kaushik565/HEMA/20D0478_20201208_1146.pdf

# REED Switches I/F

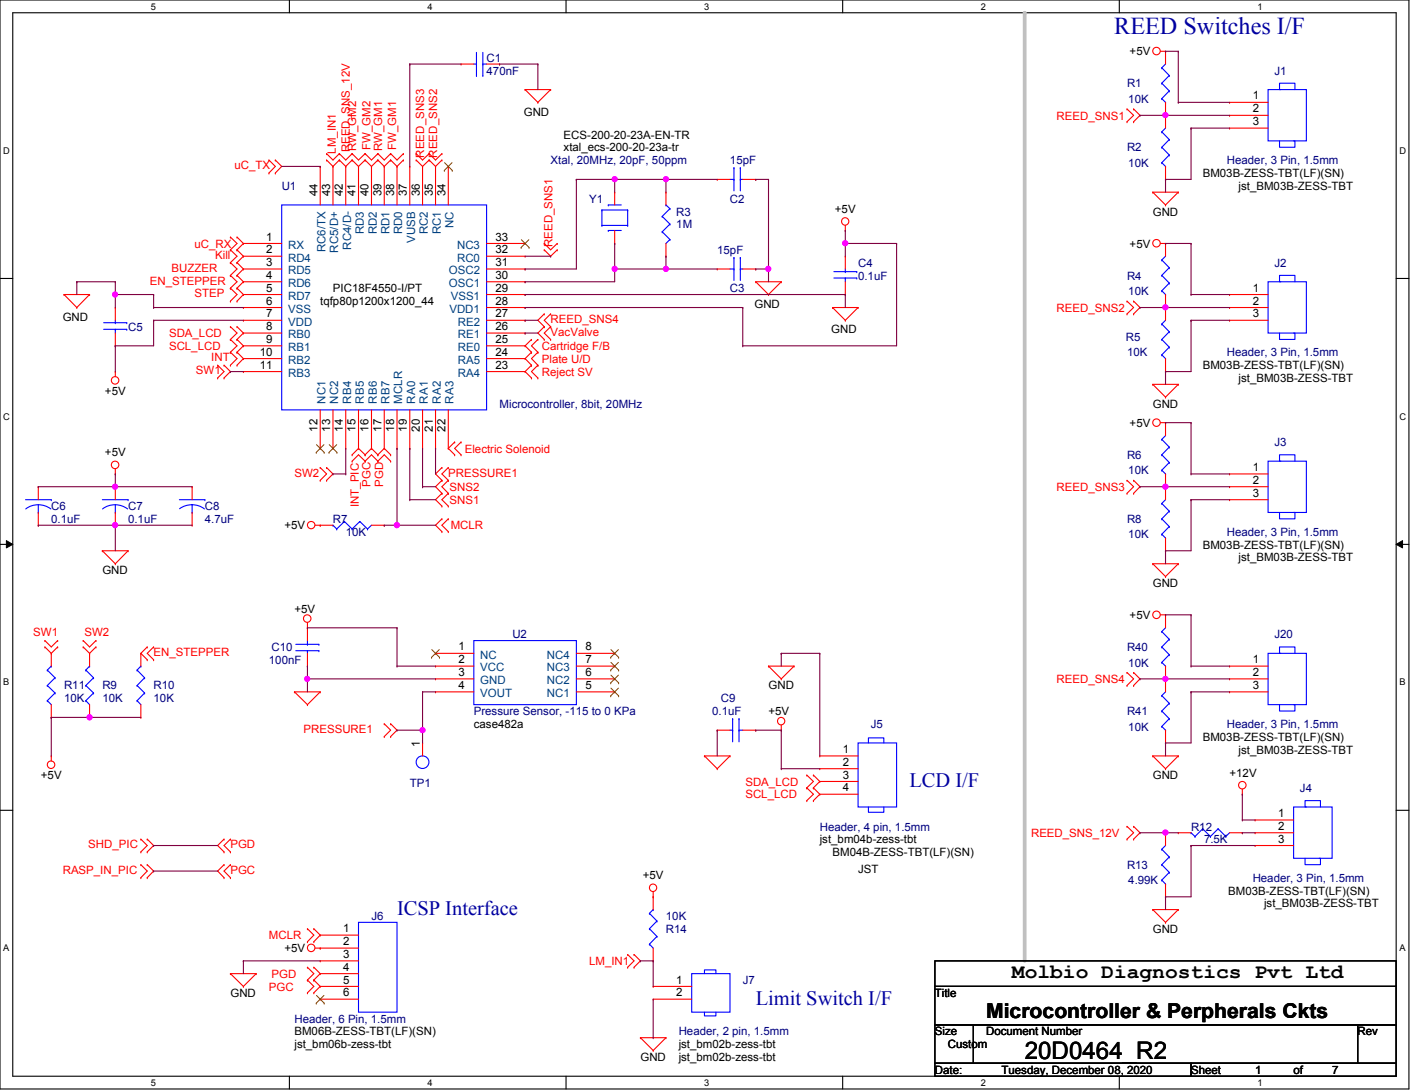
[picture p1: page 1]

Header, 3 Pin, 1.5mm
BM03B-ZESS-TBT(LF)(SN)

Pressure Sensor, -115 to 0 KPa
case482a

Header, 4 pin, 1.5mm
jst_bm04b-zess-tbt
BM04B-ZESS-TBT(LF)(SN)
JST

Molbio Diagnostics Pvt Ltd

Header, 6 Pin, 1.5mm
BM06B-ZESS-TBT(LF)(SN)
jst_bm06b-zess-tbt

## Valve Motor 1 Socket

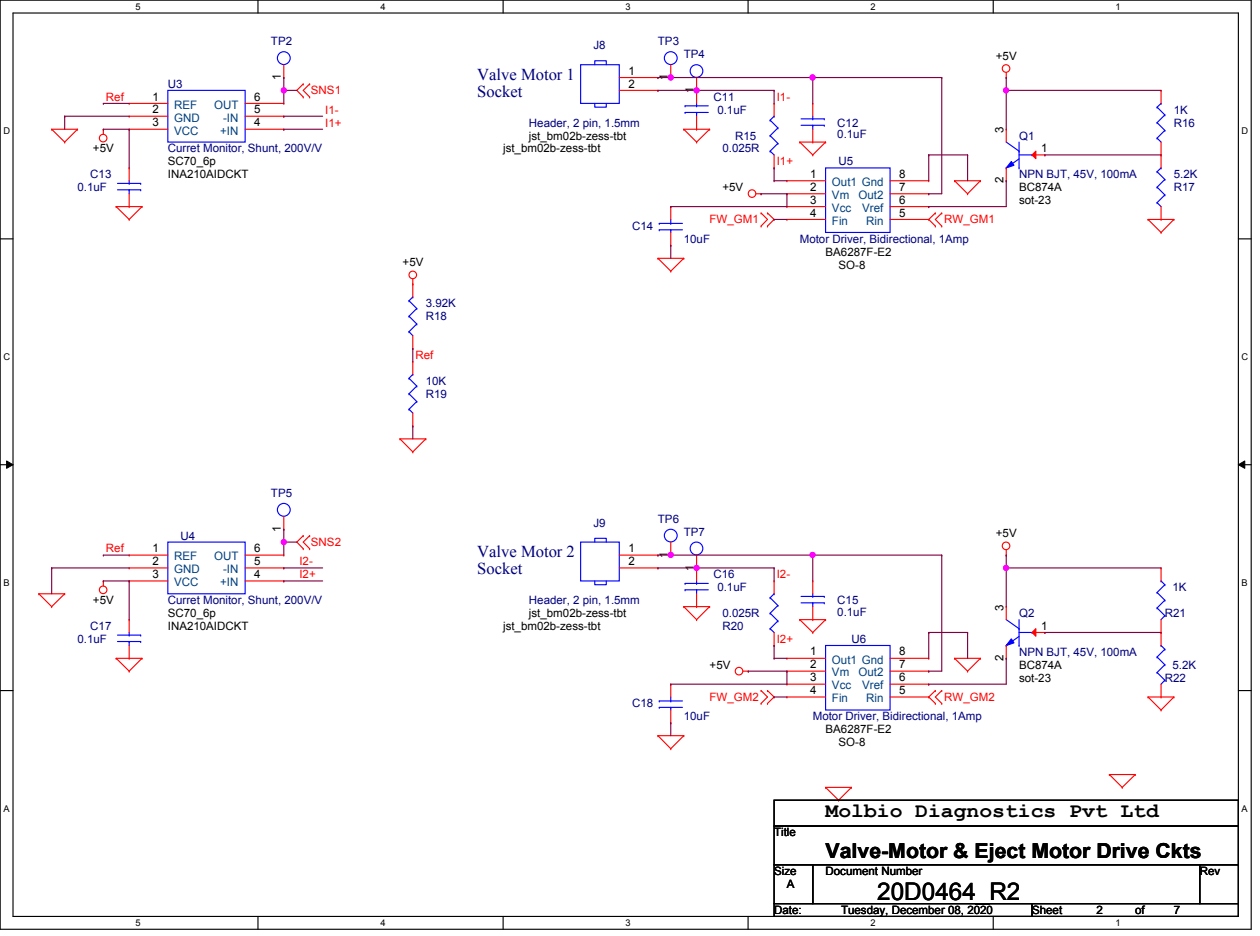
[picture p2: page 2]

Molbio Diagnostics Pvt Ltd

Title
Valve-Motor & Eject Motor Drive Ckts

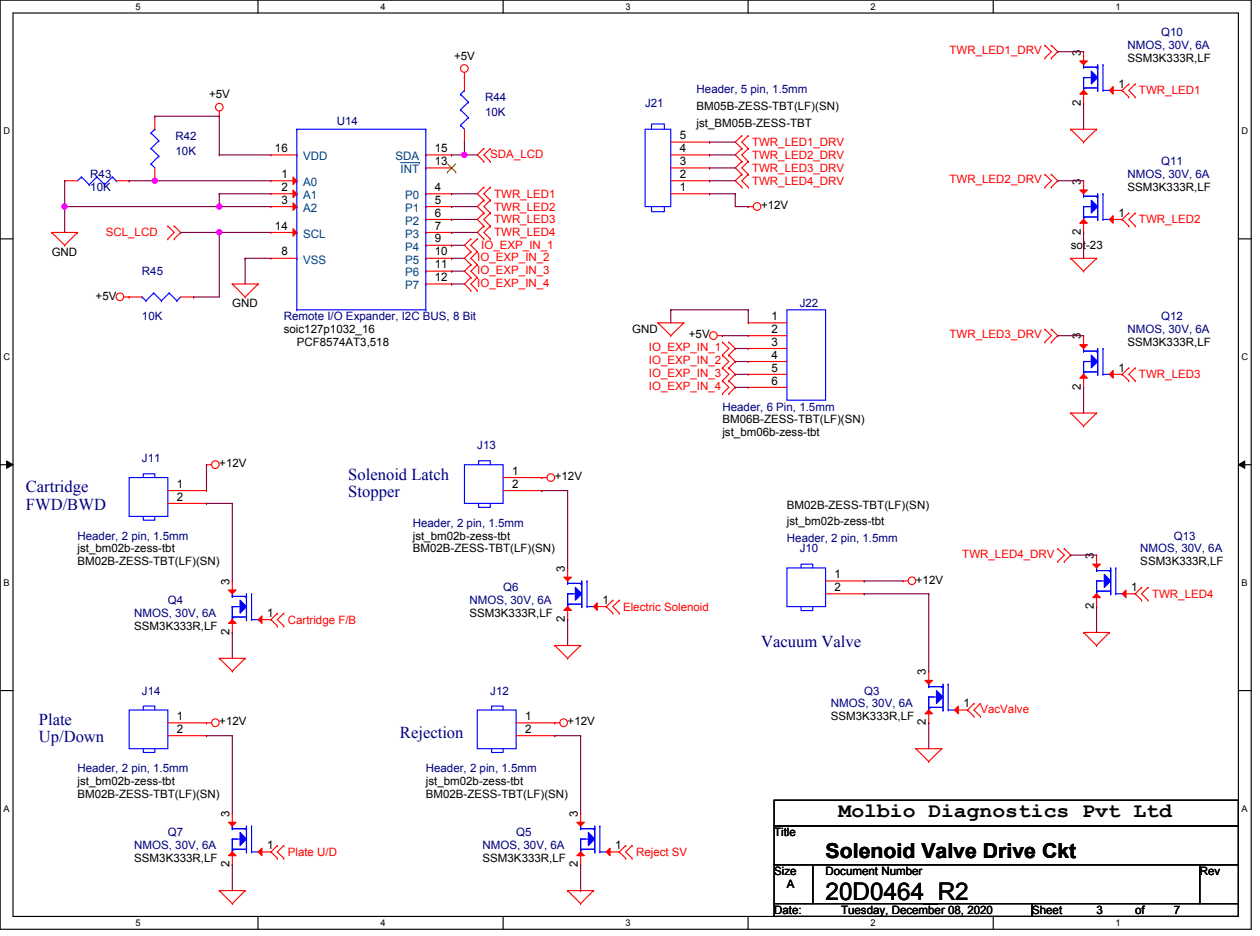
[picture p3: page 3]

Header, 6 Pin, 1.5mm
BM06B-ZESS-TBT(LF)(SN)
jst_bm06b-zess-tbt

BM02B-ZESS-TBT(LF)(SN)
jst_bm02b-zess-tbt
J10 Header, 2 pin, 1.5mm

Header, 2 pin, 1.5mm

Title
Solenoid Valve Drive Ckt

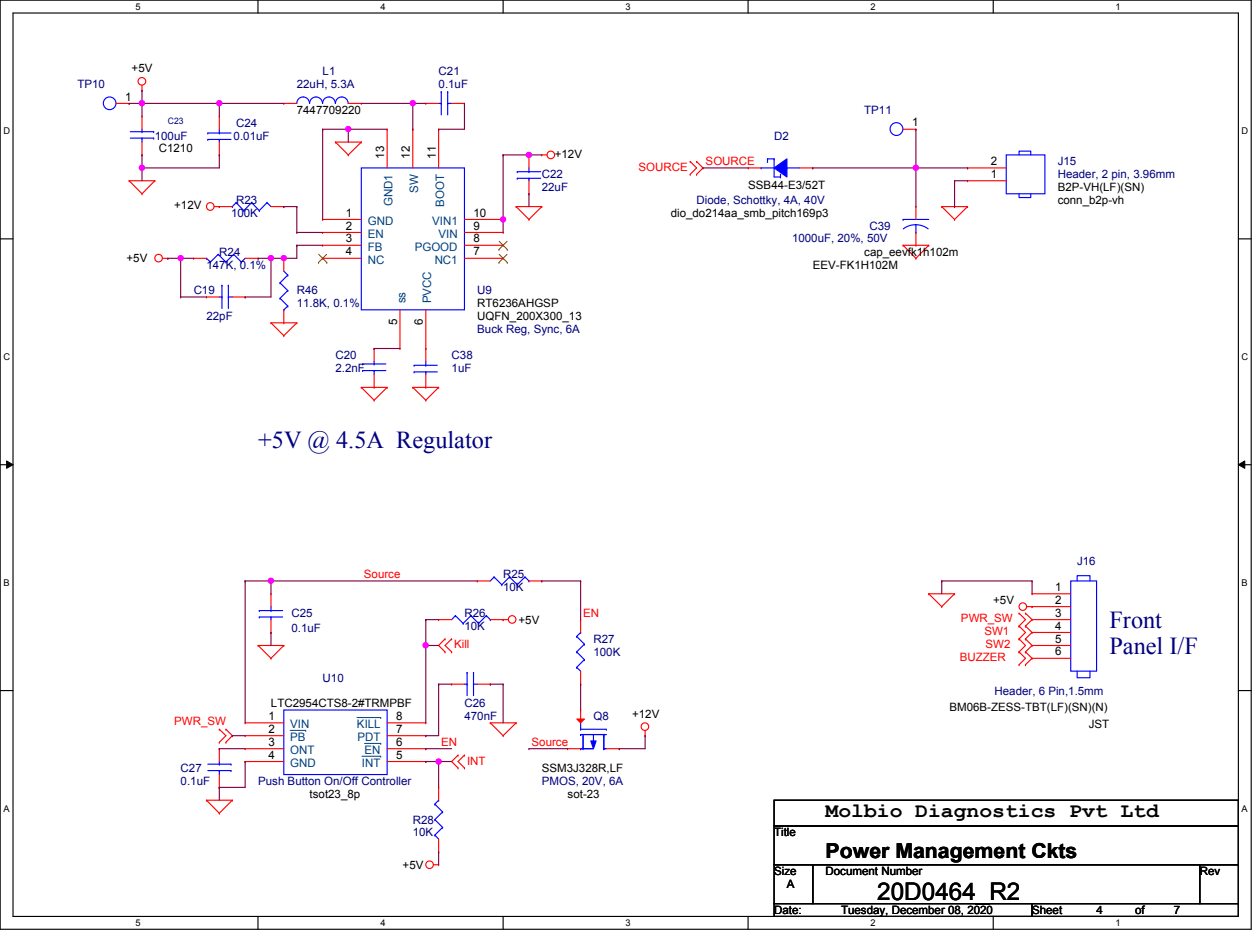
[picture p4: page 4]

BM06B-ZESS-TBT(LF)(SN)(N)

Push Button On/Off Controller

Molbio Diagnostics Pvt Ltd

SBC RTC Ckt (RPi) | RPi to uC UART interface

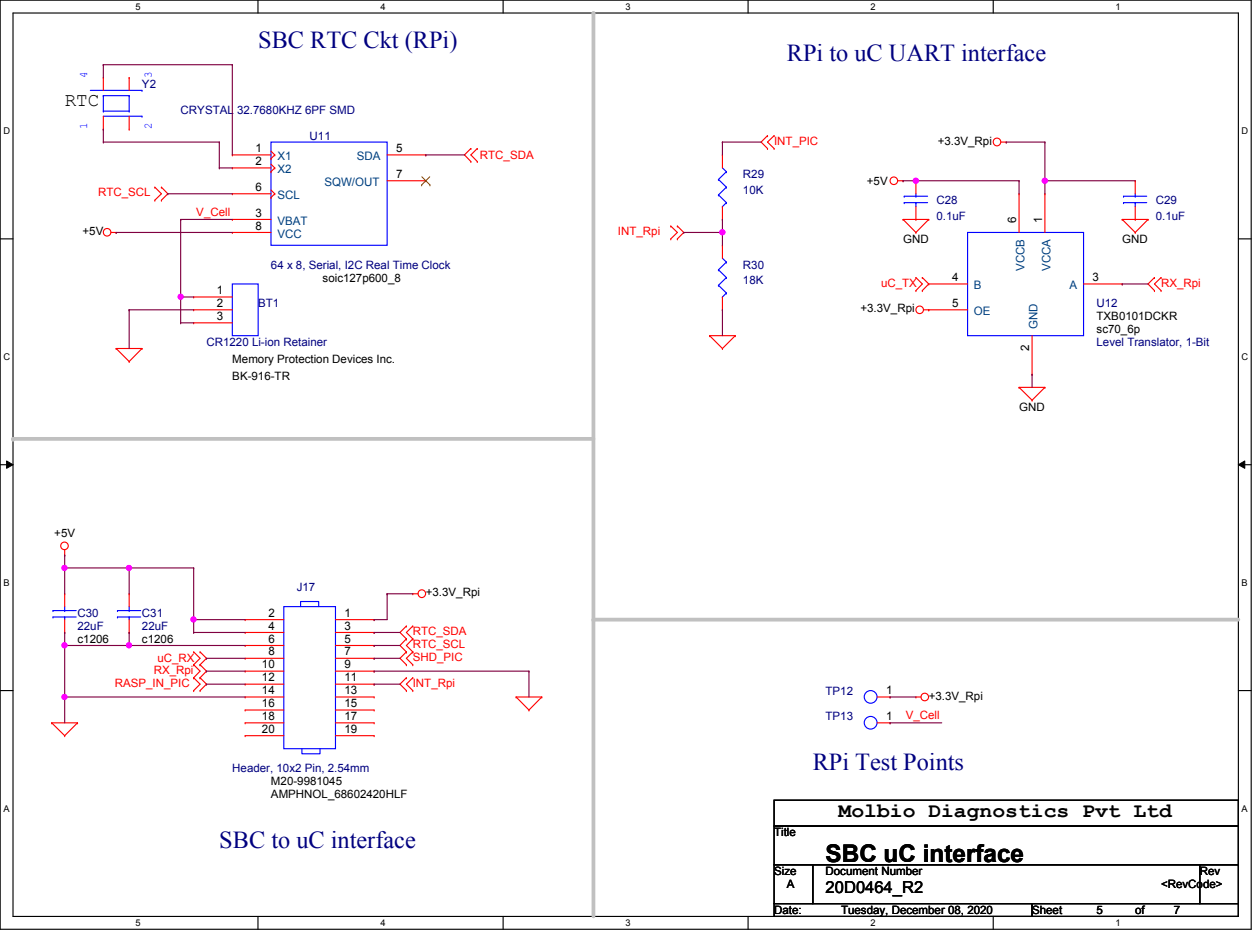
[picture p5: page 5]

64 x 8, Serial, I2C Real Time Clock

CR1220 Li-ion Retainer
Memory Protection Devices Inc.

Molbio Diagnostics Pvt Ltd
SBC uC interface

# Microstepper Connector

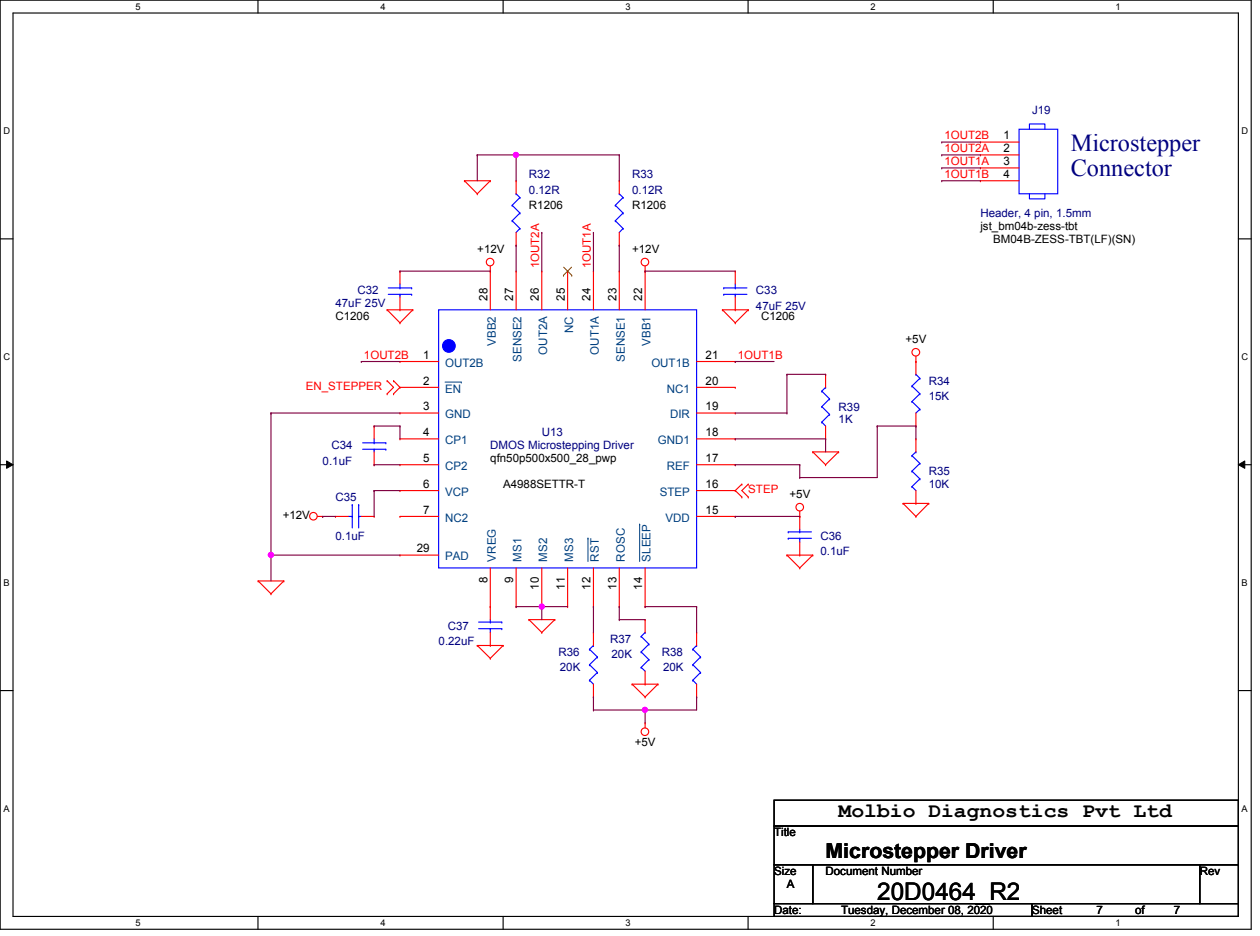
[picture p6: page 6]

Header, 4 pin, 1.5mm
jst_bm04b-zess-tbt
BM04B-ZESS-TBT(LF)(SN)

Molbio Diagnostics Pvt Ltd
